BrunoDCamargo/low-cost-PCR-instrument/Hardware/Schematic_low-cost PCR instrument.pdf

# Top Temperature Sensor A3 Bottom Temperature Sensor A1

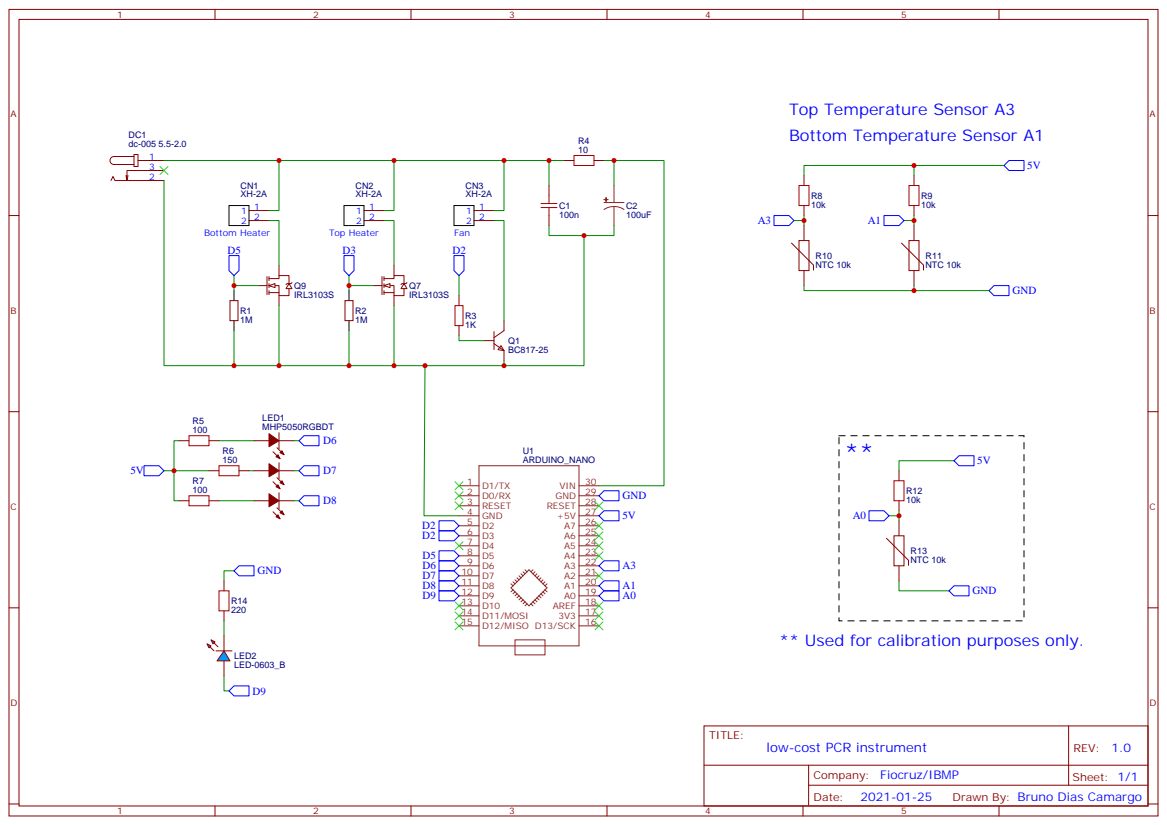
[picture p1: page 1]

** Used for calibration purposes only.

Drawn By: Bruno Dias Camargo
